attoparsec/Node/node_main.kicad_pcb

## KiCad design node_main.kicad_pcb (2021-02-15)

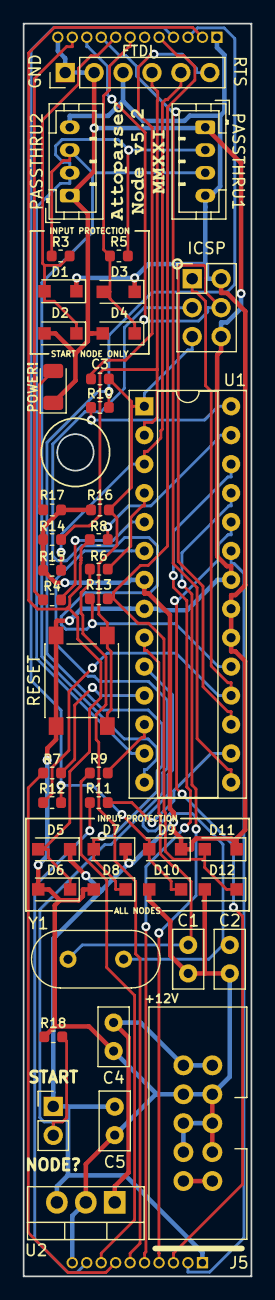
[picture p1: board node_main.kicad_pcb from above]

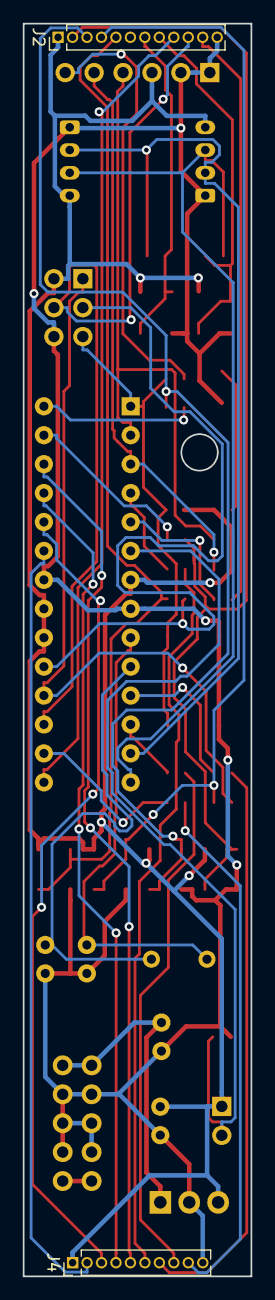
[picture p2: board node_main.kicad_pcb from below]

Board: 2 copper layers, 20.0 x 110.0 mm, 46 parts (2 on the bottom side), 40 nets.

Parts:
C1, C2: 22p; C_Disc_D5.0mm_W2.5mm_P2.50mm
C3: 100nF; C_0603_1608Metric
C4: 0.33U; C_Disc_D5.0mm_W2.5mm_P2.50mm
C5: 0.01U; C_Disc_D5.0mm_W2.5mm_P2.50mm
D1, D2, D3, D4, D5, D6, D7, D8, D9, D10, D11, D12: Bat85; D_SOD-123F
FTDI: FTDI; PinHeader_1x06_P2.54mm_Vertical
ICSP: Conn_02x03_Male; PinHeader_2x03_P2.54mm_Vertical
J2: Conn_01x12_Male; PinHeader_1x12_P1.27mm_Vertical
J4: Conn_01x10_Male; PinHeader_1x10_P1.27mm_Vertical
J5: Conn_02x05_Odd_Even; Shrouded_power_header
PASSTHRU1, PASSTHRU2: Conn_01x04_Male; JST_PH_B4B-PH-K_1x04_P2.00mm_Vertical
POWER!: LED; LED_1206_3216Metric
R3, R4, R5, R6, R7, R8, R9, R10, R11, R12, R13, R14, R15, R16, R17, R18: 1K; R_0603_1608Metric
RESET: SW_SPST; SW_SPST_PTS645
START1: Conn_01x02_Male; PinHeader_1x02_P2.54mm_Vertical
U1: ATmega328P-PU; DIP-28_W7.62mm_Socket
U2: L7805; TO-220-3_Vertical
Y1: Crystal; Crystal_HC49-U_Vertical

Connections:
+5V: C5.1, D1.1, D3.1, D5.1, D7.1, D9.1, D11.1, FTDI.3, ICSP.2, J2.1, J4.1, PASSTHRU1.4, PASSTHRU2.4, R14.1, R15.1, R16.1, R17.2, START1.1, U1.7, U1.20, U1.21, U2.3
+12V: C4.1, J5.1, J5.2, U2.1
-12V: J5.9, J5.10
APIN_0: J4.2, U1.23
APIN_1: J4.3, U1.24
APIN_2: J4.4, U1.25
APIN_3: J4.5, U1.26
APIN_4: R8.1, U1.27
APIN_5: R10.1, U1.28
CLOCK_MAIN: PASSTHRU1.3, PASSTHRU2.3, R3.1, U1.14
CRYSTAL1: C1.2, U1.9, Y1.1
CRYSTAL2: C2.2, U1.10, Y1.2
DPIN_2: R6.2, U1.4
DPIN_4: R18.2, START1.2, U1.6
DPIN_7: PASSTHRU1.2, PASSTHRU2.2, R5.1, U1.13
GND: C1.1, C2.1, C4.2, C5.2, D2.2, D4.2, D6.2, D8.2, D10.2, D12.2, FTDI.1, FTDI.2, ICSP.6, J2.12, J4.10, J5.3, J5.4, J5.5, J5.6, J5.7, J5.8, PASSTHRU1.1, PASSTHRU2.1, POWER!.1, R18.1, RESET.2, U1.8, U1.22, U2.2
INPUT_1_MAIN_RAW: D5.2, D6.1, J2.2, R8.2
INPUT_2_MAIN_RAW: D7.2, D8.1, J2.3, R10.2
INPUT_3_MAIN: ICSP.1, R12.1, U1.18
INPUT_3_MAIN_RAW: D9.2, D10.1, J2.4, R12.2
INPUT_4_MAIN: ICSP.3, R13.1, U1.19
INPUT_4_MAIN_RAW: D11.2, D12.1, J2.5, R13.2
INPUT_CLOCK_MAIN_RAW: D1.2, D2.1, J2.8, R3.2
INPUT_RESET_MAIN_RAW: D3.2, D4.1, J2.7, R5.2
LED_MAIN: J2.9, U1.15
MOSI_PWM_DPIN_11: ICSP.4, J2.10, U1.17
unnamed: C3.2, FTDI.6
unnamed: POWER!.2, R17.1
OUTPUT_1_MAIN_RAW: J4.6, R6.1
OUTPUT_2_MAIN: R7.2, U1.11
OUTPUT_2_MAIN_RAW: J4.7, R7.1
OUTPUT_3_MAIN: R9.2, U1.12
OUTPUT_3_MAIN_RAW: J4.8, R9.1
OUTPUT_4_MAIN: R11.2, U1.16
OUTPUT_4_MAIN_RAW: J4.9, R11.1
OUTPUT_IDENT_MAIN: R4.2, U1.5
OUTPUT_IDENT_MAIN_RAW: J2.11, R4.1
RESET: C3.1, ICSP.5, R16.2, RESET.1, U1.1
RX_DPIN_0: FTDI.4, R14.2, U1.2
TX_DPIN_1: FTDI.5, R15.2, U1.3
