attoparsec/Node/node_control.kicad_pcb

## KiCad design node_control.kicad_pcb (2021-02-15)

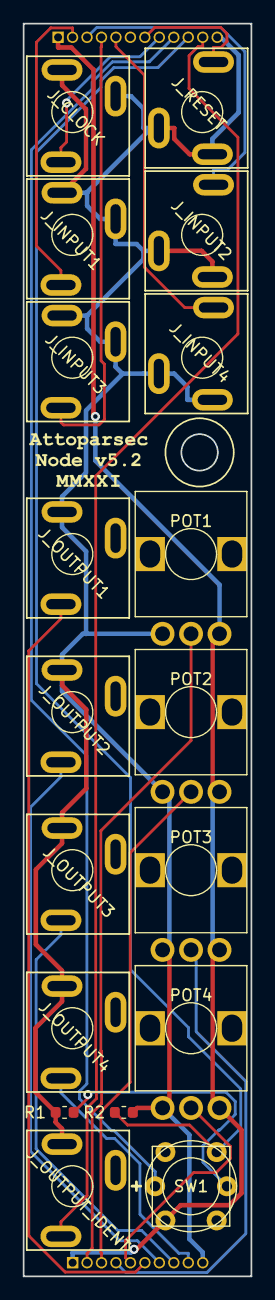
[picture p3: board node_control.kicad_pcb from above]

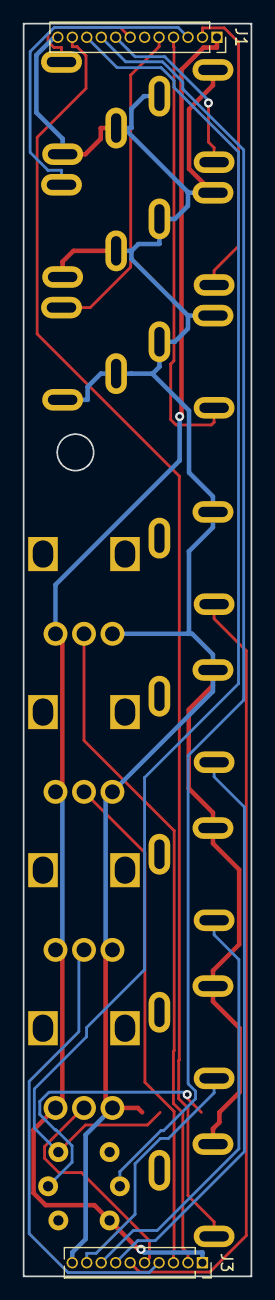
[picture p4: board node_control.kicad_pcb from below]

Board: 2 copper layers, 20.0 x 110.0 mm, 20 parts (2 on the bottom side), 20 nets.

Parts:
J1: Conn_01x12_Female; PinSocket_1x12_P1.27mm_Vertical
J3: Conn_01x10_Female; PinSocket_1x10_P1.27mm_Vertical
J_CLOCK: PJ301CM; PJ301
J_INPUT1, J_INPUT2, J_INPUT3, J_INPUT4: PJ301CM; PJ301
J_OUTPUT1, J_OUTPUT2, J_OUTPUT3, J_OUTPUT4: PJ301CM; PJ301
J_OUTPUT_IDENT: PJ301CM; PJ301
J_RESET: PJ301CM; PJ301
POT1, POT2, POT3, POT4: 10K; P090S_pot
R1, R2: 1K; R_0603_1608Metric
SW1: TL1265; TL1265_ILLUMINATED_TACTILE_SWITCH

Connections:
+5V: J1.1, J3.1, POT1.3, POT2.3, POT3.3, POT4.3, SW1.4
GND: J1.12, J3.10, J_CLOCK.1, J_CLOCK.2, J_INPUT1.1, J_INPUT1.2, J_INPUT2.1, J_INPUT2.2, J_INPUT3.1, J_INPUT3.2, J_INPUT4.1, J_INPUT4.2, J_OUTPUT1.1, J_OUTPUT2.1, J_OUTPUT3.1, J_OUTPUT4.1, J_OUTPUT_IDENT.1, J_RESET.1, J_RESET.2, POT1.1, POT2.1, POT3.1, POT4.1, R1.1, R2.1
INPUT_1_CONT: J1.2, J_INPUT1.3
INPUT_2_CONT: J1.3, J_INPUT2.3
INPUT_3_CONT: J1.4, J_INPUT3.3
INPUT_4_CONT: J1.5, J_INPUT4.3
INPUT_CLOCK_CONT: J1.8, J_CLOCK.3
INPUT_RESET_CONT: J1.7, J_RESET.3
LED_CONT: J1.9, SW1.6
unnamed: R1.2, SW1.5
OUTPUT_1_CONT: J3.6, J_OUTPUT1.3
OUTPUT_2_CONT: J3.7, J_OUTPUT2.3
OUTPUT_3_CONT: J3.8, J_OUTPUT3.3
OUTPUT_4_CONT: J3.9, J_OUTPUT4.3
OUTPUT_IDENT_CONT: J1.11, J_OUTPUT_IDENT.3
POT_1_CONT: J3.2, POT1.2
POT_2_CONT: J3.3, POT2.2
POT_3_CONT: J3.4, POT3.2
POT_4_CONT: J3.5, POT4.2
SWITCH_CONT: J1.10, R2.2, SW1.1
